radiodan-archive/project/README.md

Proposal
========

Proposal documents for the radiodan project.
