radiodan-archive/project/docs/assets/README.md

The latest version is

radiodan_3mm_laser_template.pdf
 red = cut
 blue = score
 black = etch

The old avoider box is 

radiodan_box_final.pdf
 red = cut
 blue = score
