radiodan-archive/project/docs/physical_ui_pcb_v1.md

Radiodan PCB
===

These instructions cover using the custom-made Radiodan PCB.

Components
---

 - 4 x 68R resistors
 - 2 x 120R resistors
 - 2 x RGB Rotary Encoder
 - 1 x Tactile button
 - 1 x 26-pin boxed header

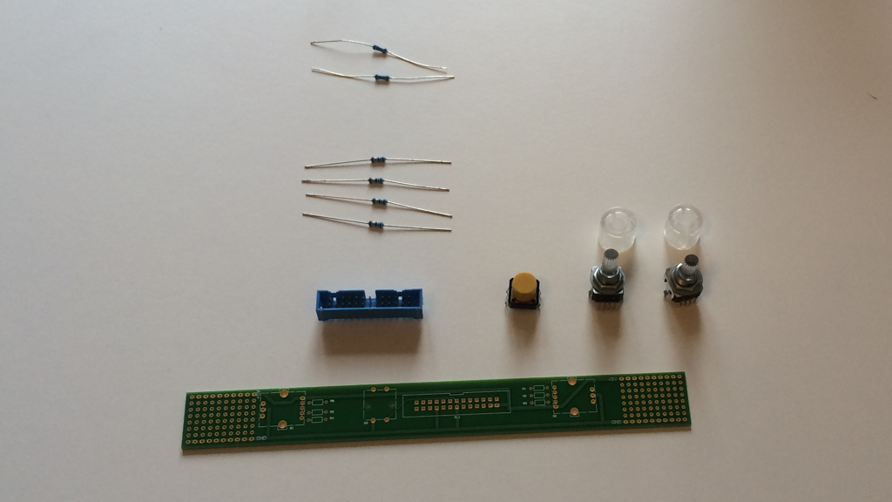
[picture p1: docs/assets/physical-ui-pcb-v1/0.jpg]


Instructions
---

1. Start with the 2 120R resistors.
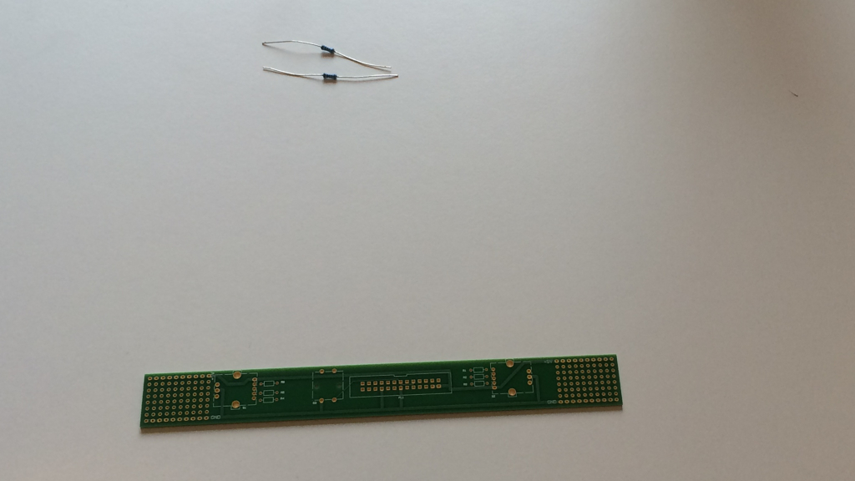
[picture p2: docs/assets/physical-ui-pcb-v1/1.jpg]


2. The go in the holes marked R1 and R4. The solid box outline should be facing up.
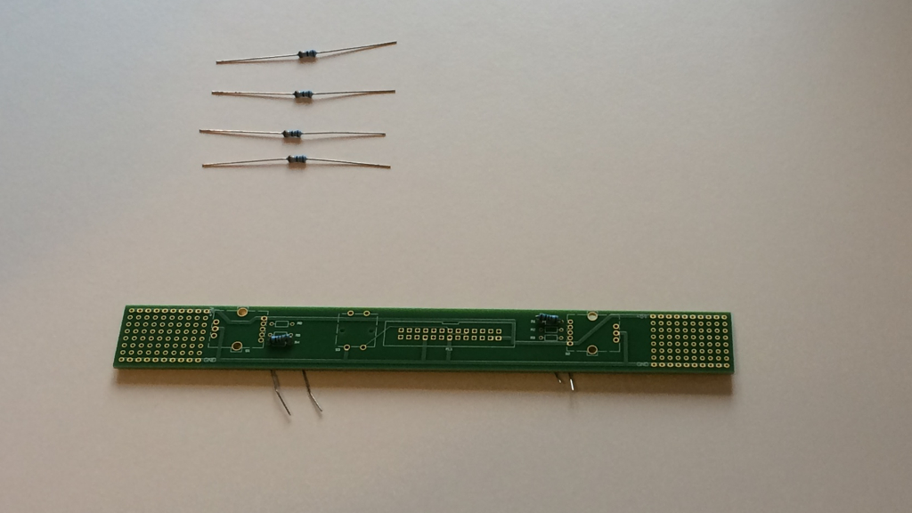
[picture p3: docs/assets/physical-ui-pcb-v1/2.jpg]


3. Next fill the other 4 boxes marked R with the remaining 4 resistors.
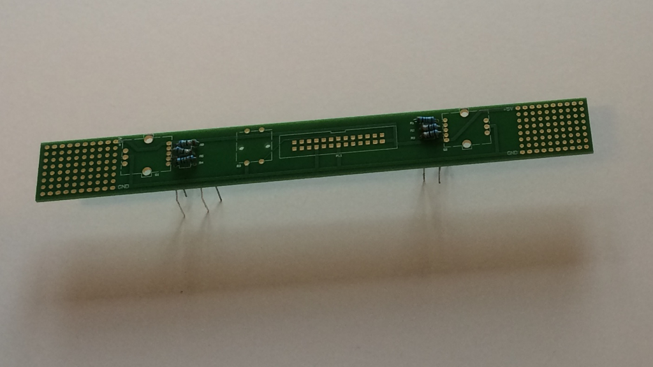
[picture p4: docs/assets/physical-ui-pcb-v1/3.jpg]


4. Turn PCB over and solder
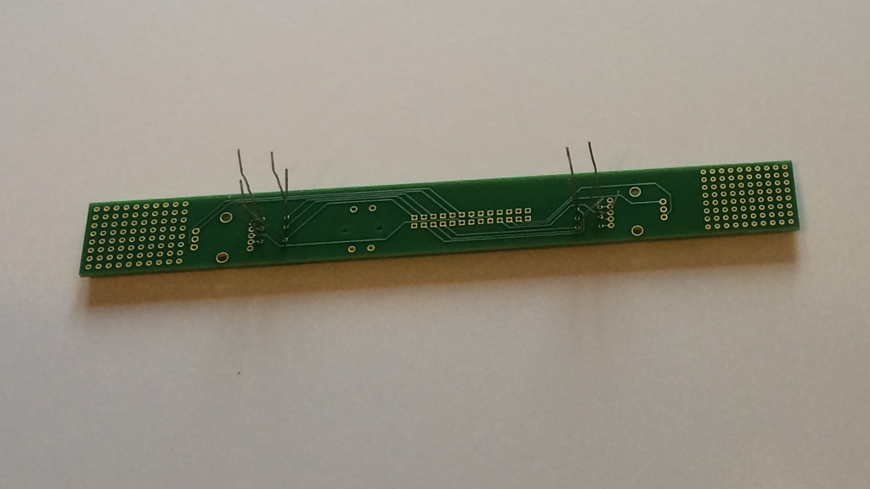
[picture p5: docs/assets/physical-ui-pcb-v1/4.jpg]


5. Soldered
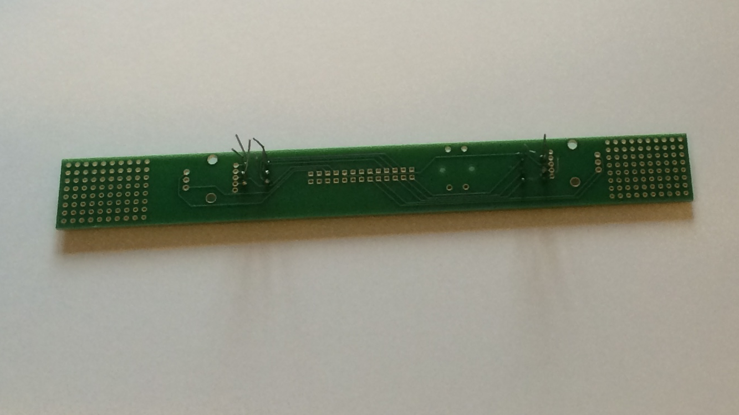
[picture p6: docs/assets/physical-ui-pcb-v1/5.jpg]


6. The header box is next. The printed shapes should be facing up and the notch in the header should match the notch in the printed outline.
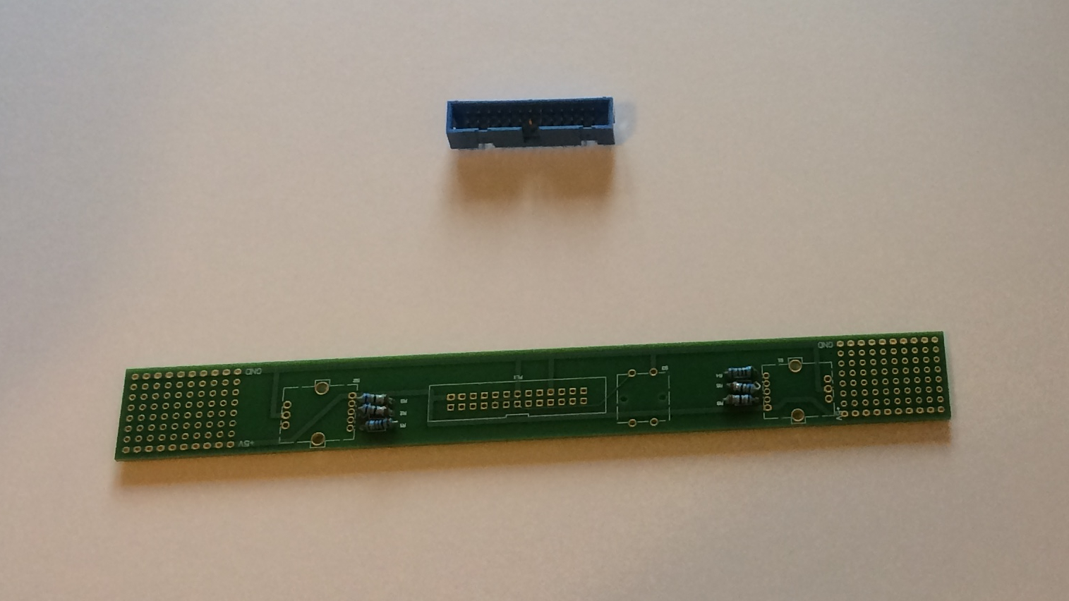
[picture p7: docs/assets/physical-ui-pcb-v1/6.jpg]


7. The header in position.
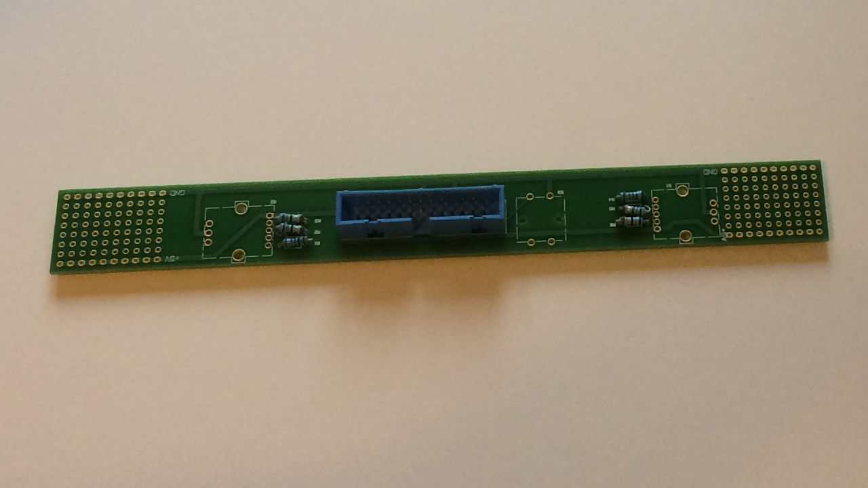
[picture p8: docs/assets/physical-ui-pcb-v1/7.jpg]


8. Turn the PCB over and solder.
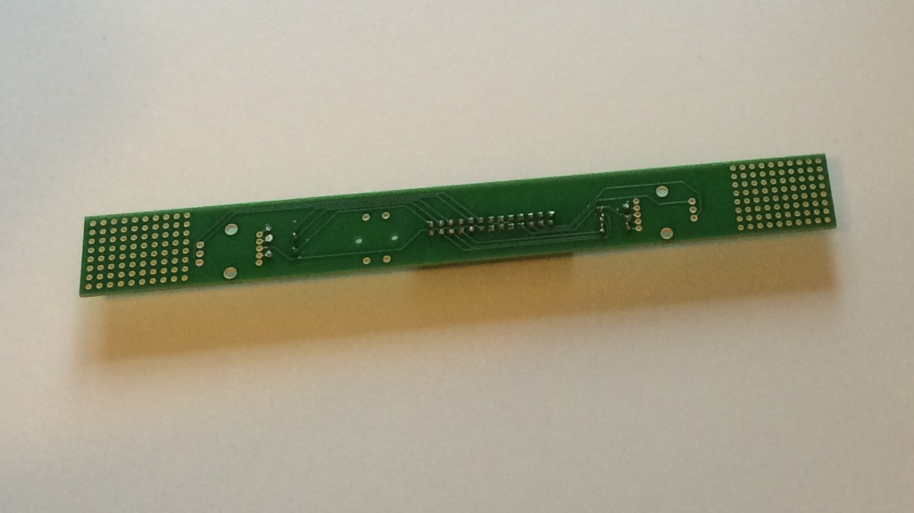
[picture p9: docs/assets/physical-ui-pcb-v1/8.jpg]


9. The tactile button is next. Since the button outline is dotted the component must be soldered on the BACK of the PCB.
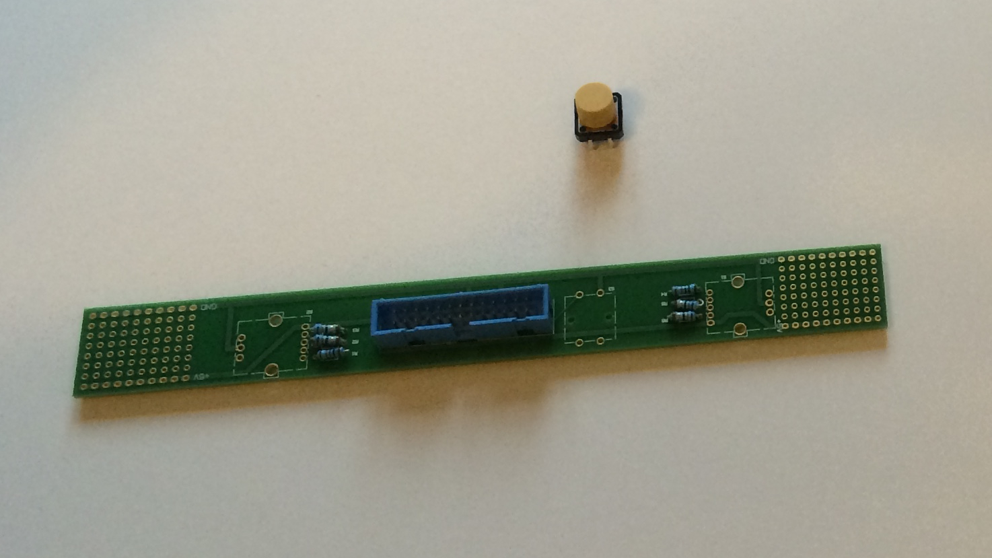
[picture p10: docs/assets/physical-ui-pcb-v1/9.jpg]


10. Turn the PCB over.
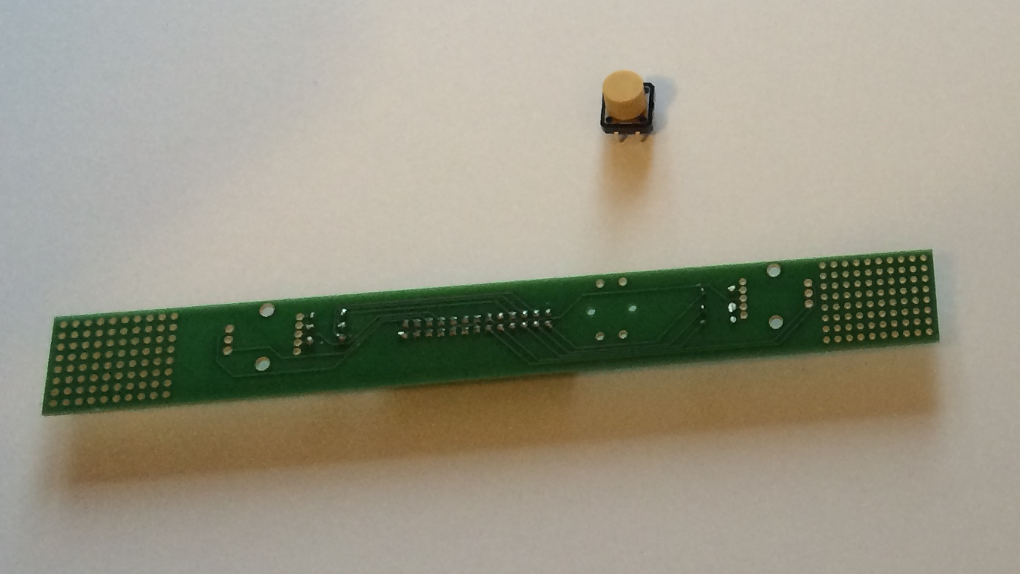
[picture p11: docs/assets/physical-ui-pcb-v1/11.jpg]


11. The button clips into the holes. It only fits easily one way.
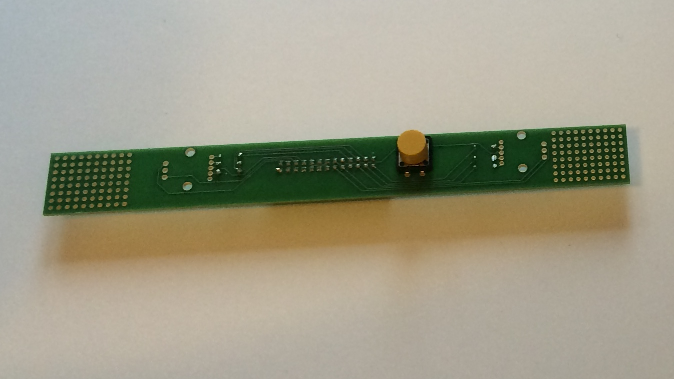
[picture p12: docs/assets/physical-ui-pcb-v1/12.jpg]


12. Turn the PCB over again and solder the legs.
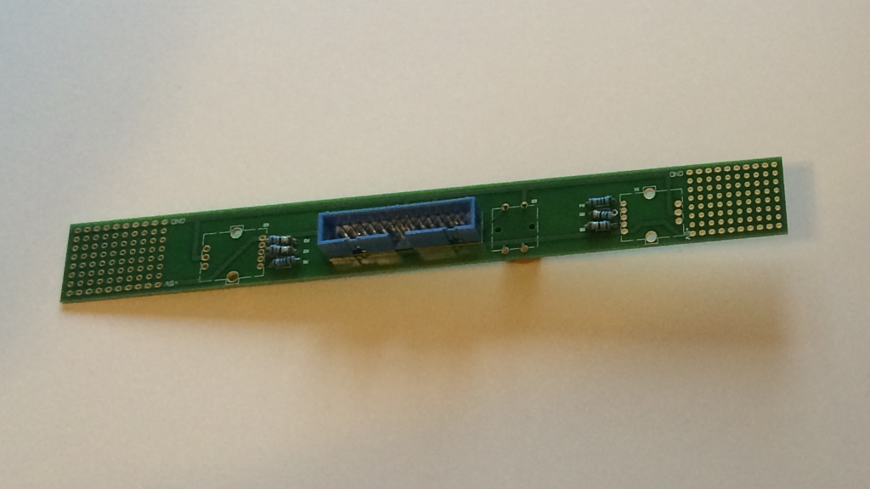
[picture p13: docs/assets/physical-ui-pcb-v1/13.jpg]


13. The 2 rotary encoders' outlines on the PCB are also dotted so they go on the other side, just like the tactile button.
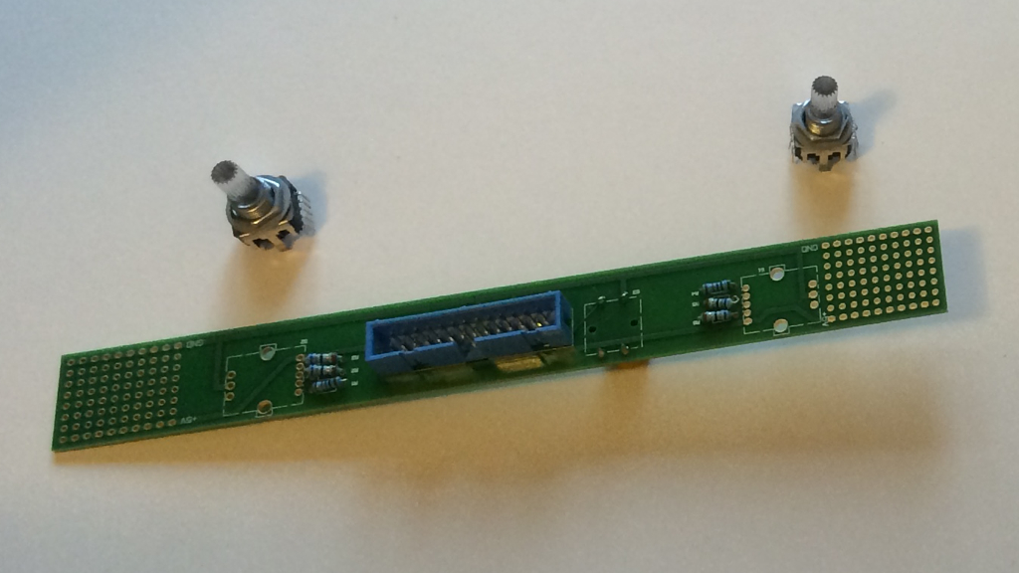
[picture p14: docs/assets/physical-ui-pcb-v1/14.jpg]


14. Turn the PCB over...
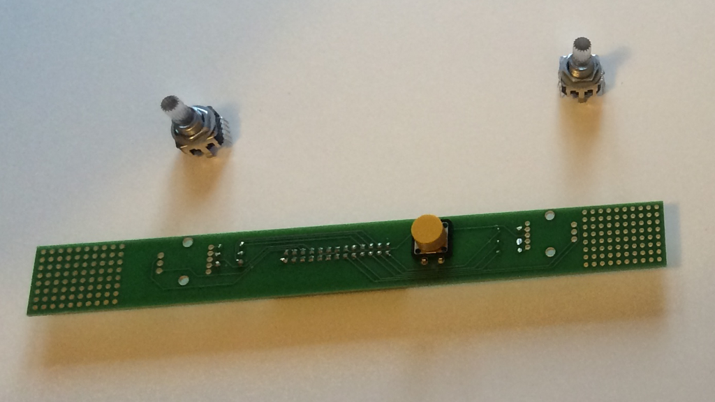
[picture p15: docs/assets/physical-ui-pcb-v1/15.jpg]


15. The legs will only fit in a single orientation
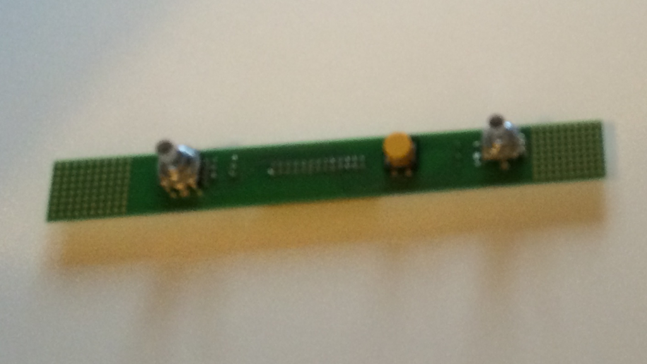
[picture p16: docs/assets/physical-ui-pcb-v1/16.jpg]


16. A box with holes cut out to fit the encoder poles is useful to stop the PCB wobblying as you solder.
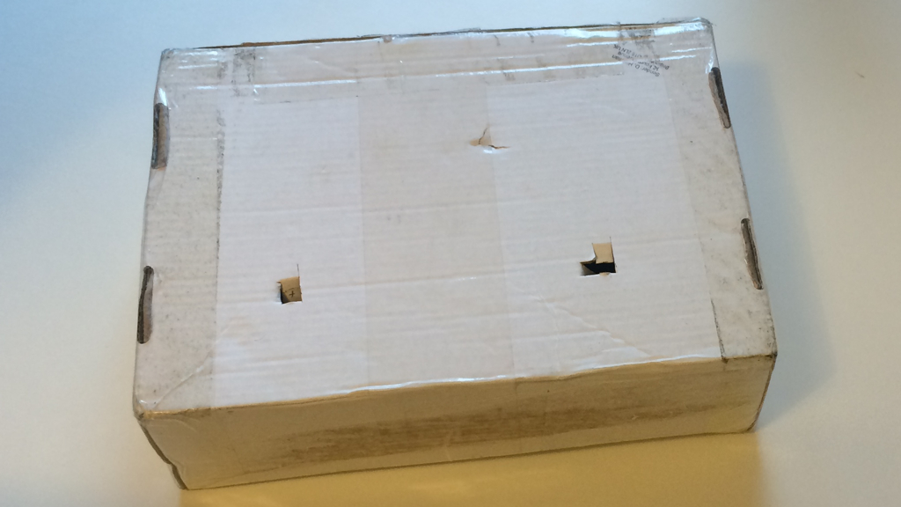
[picture p17: docs/assets/physical-ui-pcb-v1/18.jpg]


17. Rest the encoders in the holes and solder. Make sure you apply pressure to the PCB to ensure the legs are pushed through.
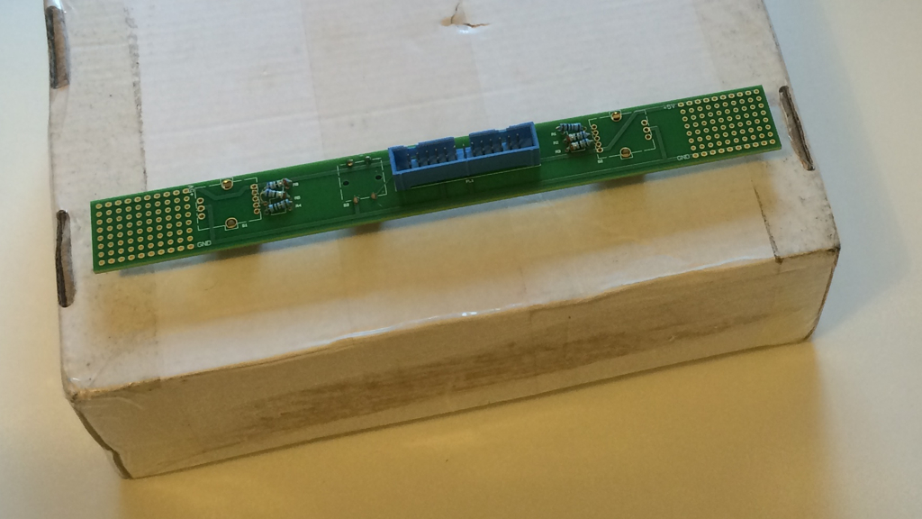
[picture p18: docs/assets/physical-ui-pcb-v1/19.jpg]


18. Soldered!
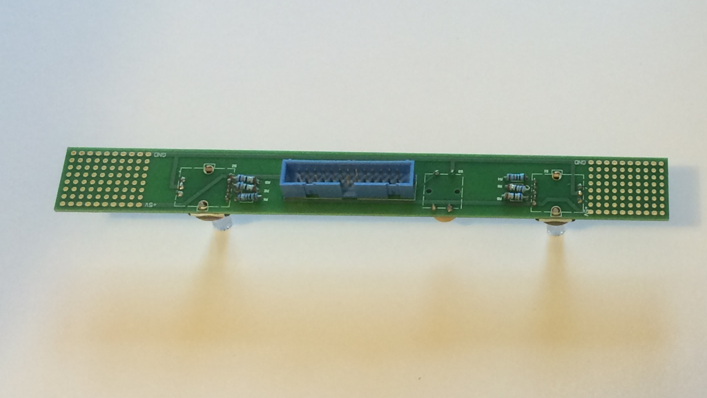
[picture p19: docs/assets/physical-ui-pcb-v1/20.jpg]


19. Done!
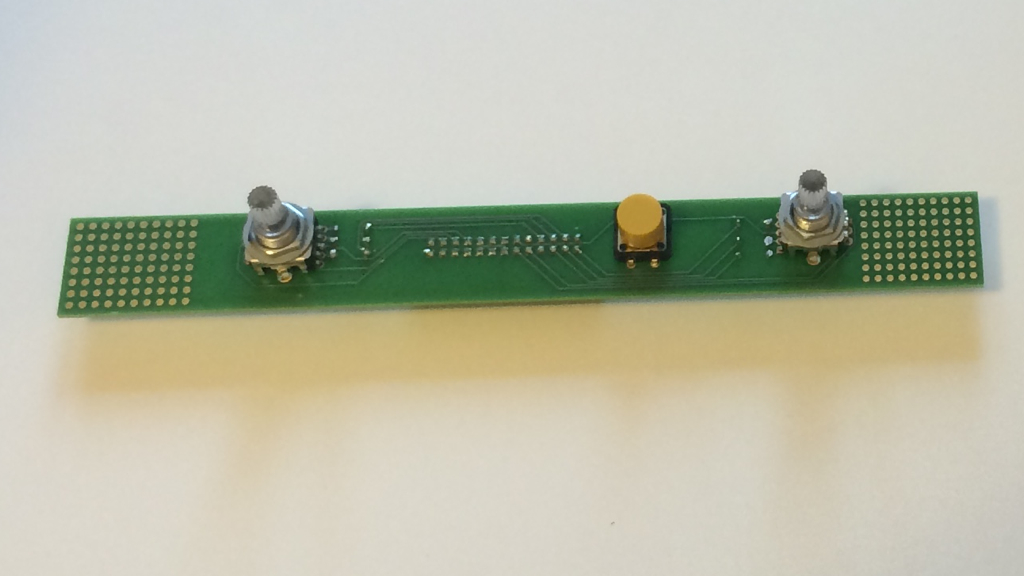
[picture p20: docs/assets/physical-ui-pcb-v1/21.jpg]
