radiodan-archive/project/applications/developer_kit/developer_kit.markdown

# Radiodan Wrong Radio application developer kit

A kit (initially a list of parts plus documentation) to allow you to make your 
own 'wrong radio'. What would it take so that anyone could make a customised 
radio - including the physical buttons, dials etc?
