radiodan-archive/project/docs/box_design.markdown

# Box Design for Radiodan

This is a very simple box, but it works. It was created by Neil Ferguson of [Bristol Design 
Forge](http://www.bristoldesignforge.co.uk). Feel free to use and adapt it as you like.

Red lines are cuts, blue are scored.

[Box design pdf](assets/radiodan_box_final.pdf)

[Box design eps](assets/radiodan_box_final.eps.zip) (zipped)

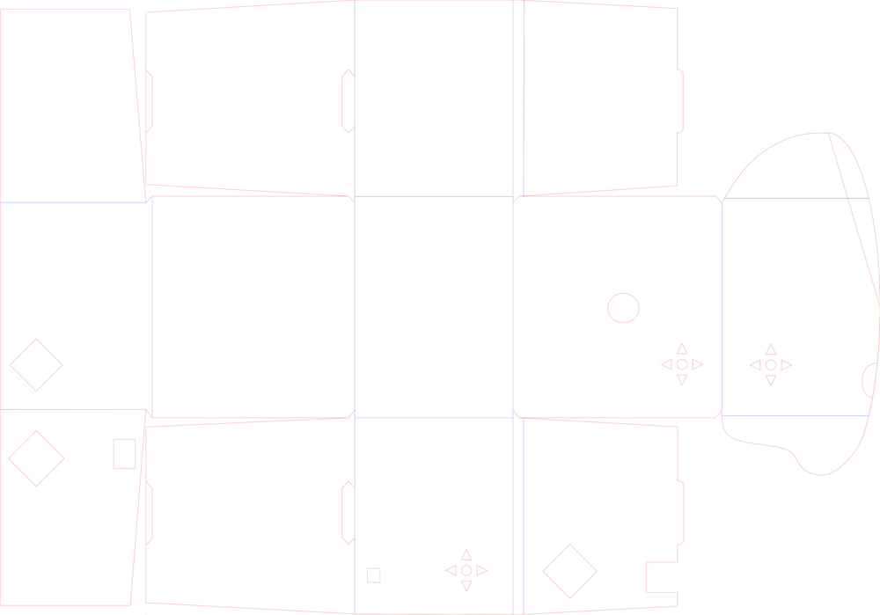
[picture p25: docs/assets/radiodan_box_final.png]
Box design image
