radiodan-archive/project/docs/assets/physical-ui-pcb-v1/17.jpg

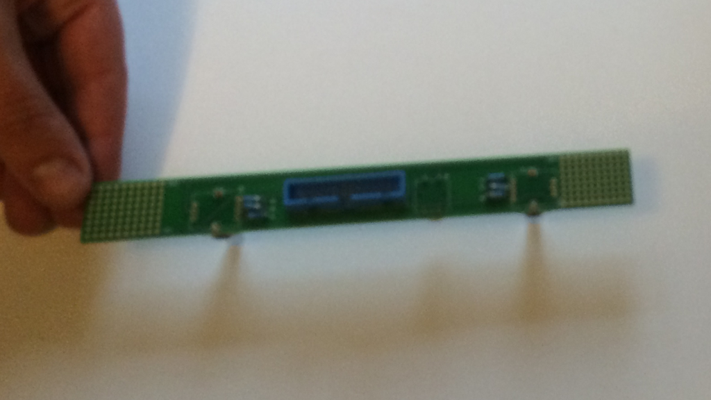
docs/assets/physical-ui-pcb-v1/17.jpg
