radiodan-archive/project/docs/assets/Radiodan_app_simple.png

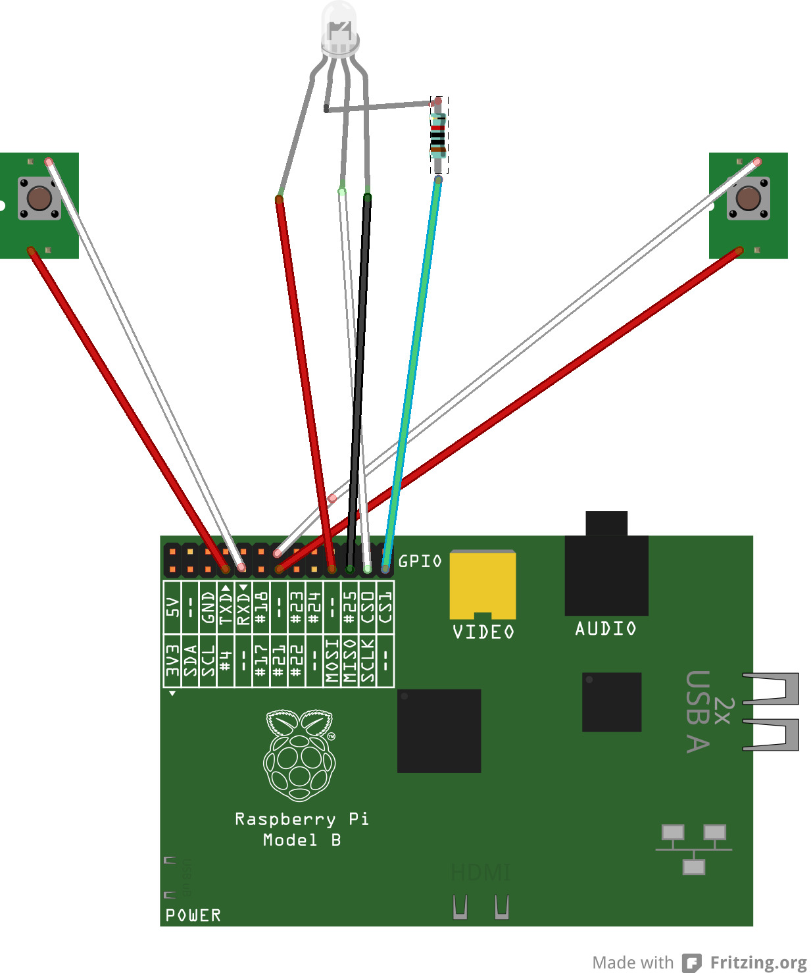
docs/assets/Radiodan_app_simple.png
