radiodan-archive/project/TODO.md

## General

* decide on a first application to make
* work out how best to do the wifi access
* work out how to run radiodan with [wiringpi](http://pi.gadgetoid.com/post/015-wiringpi-now-with-serial) or similar
* work out a kit list

## Time travel app

* try a ruby version of the [rotary encoder](http://planb.nicecupoftea.org/2013/06/30/rotary-encoder-for-the-raspberry-pi/)
* try a test schedule with a speaking dial

## Archers Avoider

* get it all working automatically on startup 
* work out the simplest alternative content to play and how to get it
