radiodan-archive/project/docs/assets/radiodan_3mm_laser_template.pdf

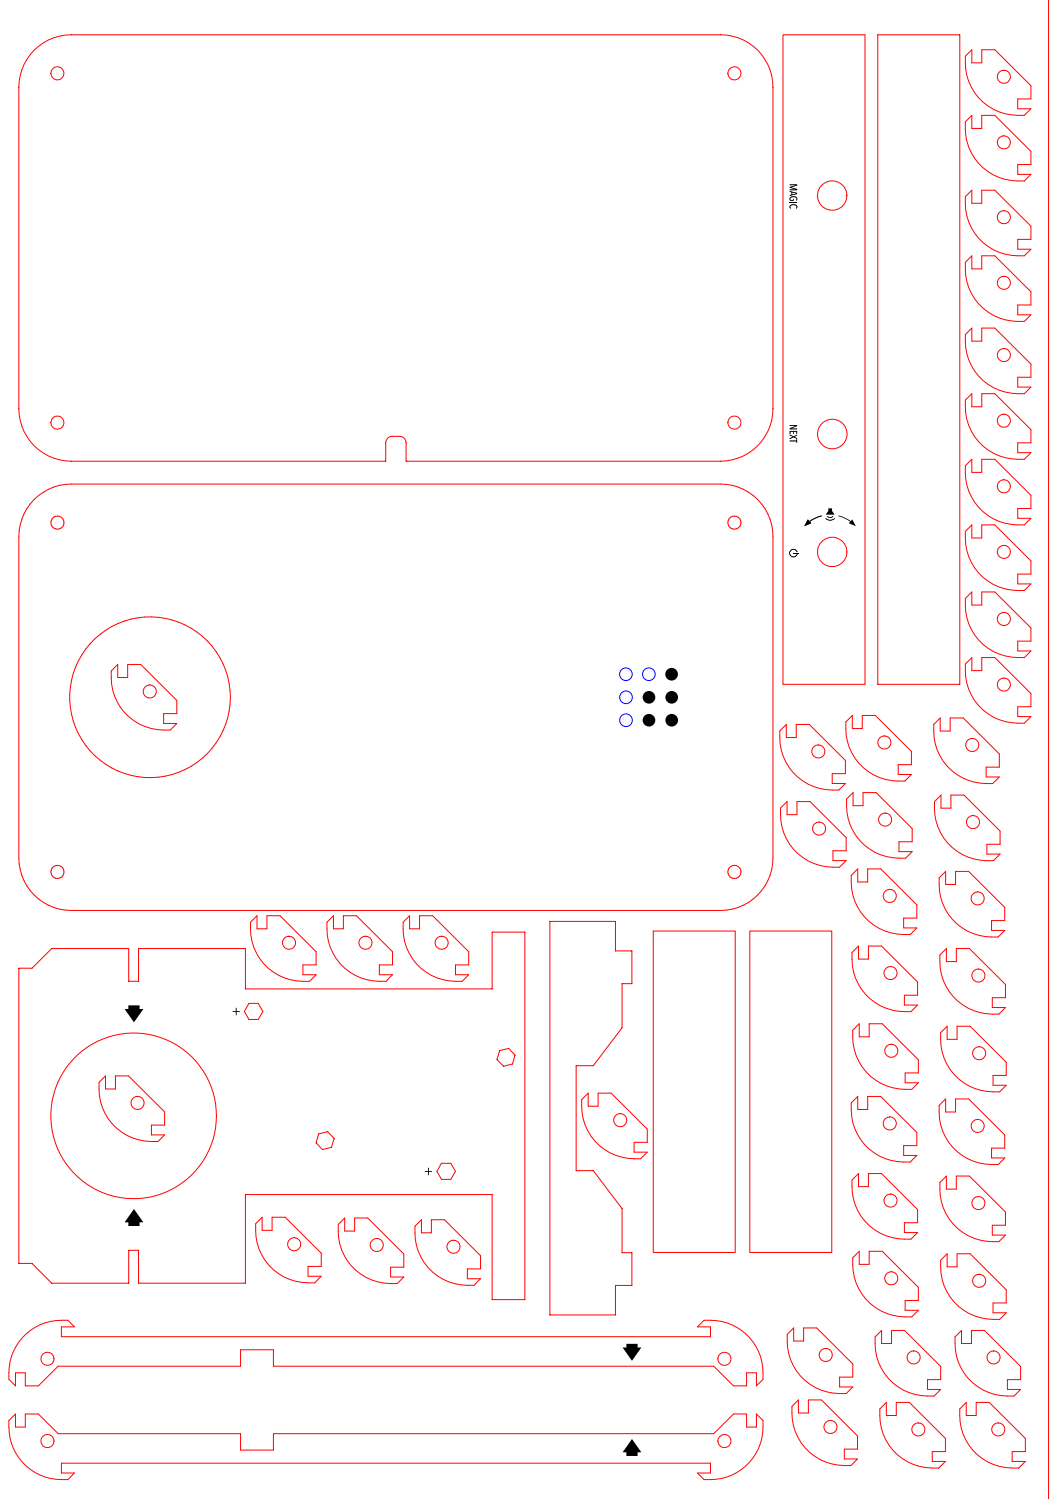
[picture p49: page 1]
