radiodan-archive/project/docs/assets/radiodan_box_final.pdf

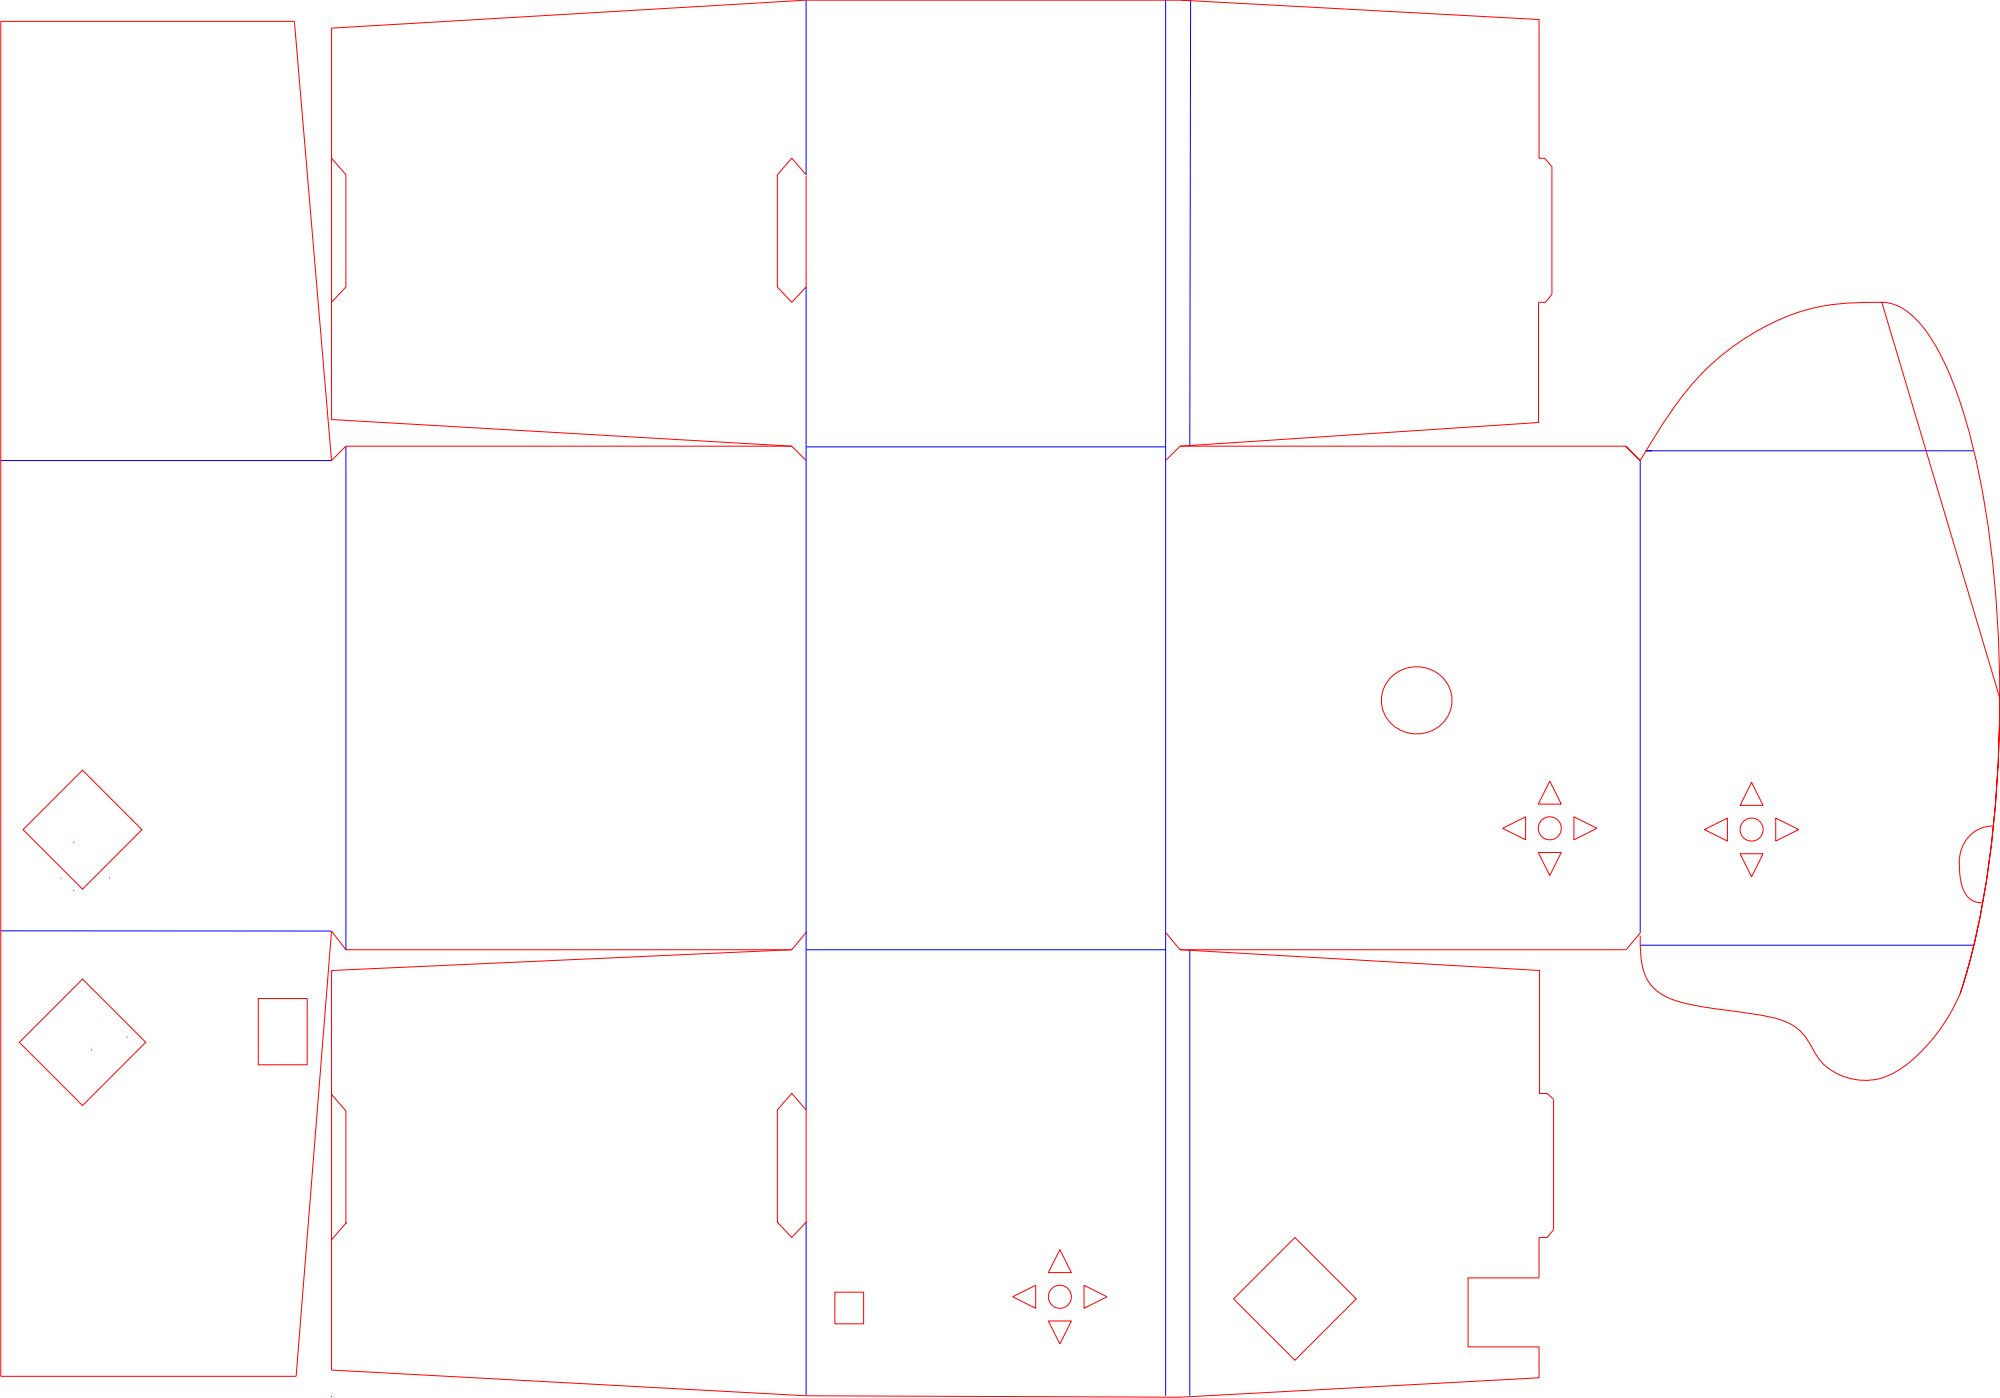
[picture p50: page 1]
