radiodan-archive/project/(list of files, drawings)

Other design files:
docs/assets/Radiodan_app.fzz
docs/assets/Radiodan_app_simple.fzz
