radiodan-archive/project/(commit log)

2013-12-24 Commit forgotten assets, fix typo
    [Radiodan_app.fzz]
2014-08-01 Add 3mm laser template
2014-08-01 Add updated Fritzing diagram and png
    [Radiodan_app.fzz]
2014-08-01 Add first pass at case construction instructions
2014-08-01 Add another link to the case
2014-08-07 Add simple fritzing diagrams
    [Radiodan_app_simple.fzz]
2014-08-07 Updated colours and resistor
    [Radiodan_app_simple.fzz]
2014-09-24 PCB instructions
2014-09-30 Fix resistor labels
